Flayun/Projet_Arduino_Peip2/README.md

# Projet_Arduino_Peip2
Jeu d'échecs électronique
