Flayun/Projet_Arduino_Peip2/Rapport_Séance/Rapport de seance 7 Arthur Soens.pdf

## Rapport de la séance 7

Soens Arthur

J’ai , aujoud’hui , fiis les fotios utiles pou le dplaeet des pies ’est-à-dire celles liée à la

## pie ui , elle , peut aiteat se efee et s’ouvi , gâe à ei j’ai pu fialise la fotio ui

permet de prendre les pièces capturées pour les mettre hors du plateau de jeu. Pour ouvrir ou fermer la pince on utilise un servomoteur.

Initialisation du servomoteur :

//ServoMoteur

Servo servo;// rajouter les valeurs

byte pinServo;

void setup() {

//reglage servomoteur

servo.attach(pinServo);

Serial.println("Moteur initialisation");

}

Fonction pour ouvrir et fermer le moteur :

void fermerPince(){

servo.write(80);

}

void ouvrirPince(){

servo.write(30);

}

J’ai aussi amélioré le programme en remplaçant les « int » par des « byte » comme ci-dessous :

const byte stepPin = 3;

const byte dirPin = 4;

const byte stepPin2 = 6;

const byte dirPin2 = 7;

const byte stepPin3 = 13;

const byte dirPin3 = 14;

const byte stepPin4;//Rajouter les valeurs

const byte dirPin4;

## Et voii la fotio ui peet de pede la pie et l’expulse du jeu :

void piecePrise(int x, int y){

avancer_X_caseH(x);

avancer_X_caseV(y);

descendreLaPince(x, y);

fermerPince();

remonterLaPince(x, y);

avancer_X_caseH(10);

ouvrirPince();

}

## De plus , j’ai aid Ea à fialise la stutue e fixat ie les paeaux du as au aatue

talliue aisi u’e ajoutat ue aatue pou aohe u toisie oteur.
