Flayun/Projet_Arduino_Peip2/Rapport_Séance/Rapport de séance 8 Arthur Soens.pdf

### Rapport de la séance 8

Soens Arthur

J’ai , aujourd’hui , rajouté un support pour le moteur qui déplacera horizontalement la pince , ce support a pour but de stabiliser le dit moteur afin de le déplacer sans problème, néanmoins , le moteur n’agit pas exactement de la manière dont on espérait car il effectue une rotation au lieu d’un translation , mais nous pensons régler le problème en le bloquant par derrière limitant les possibilités de rotation. De plus , nous avons réglé un problème qui empêché la pince de fonctionner , ceci en remplaçant les pins dédiés à la pince. Nous avons aussi effectué et réussi un test de déplacement vertical et horizontal de la barre , il ne nous reste plus qu’à monter la pince et sa poulie sur le
système se déplaçant .
