Flayun/Projet_Arduino_Peip2/Rapport_Séance/Rapport de seance 6 Arthur Soens.pdf

Rapport de la séance 6

Soens Arthur

## J’ai aujoud’hui alio o pogae e ajoutat ue fotio peettat de vifie la taille des pies , pou e faie j’ai epla les pies hautes pa des à la plae de puis j’ai ue

fonction de vérification qui renvoie un booléen :

boolean verifierTaille(int x, int y){

if(jeu[x][y] == 1){

return true;//pièce de petite taille

}

else if(jeu[x][y] == 2){

return false;//pièce de grande taille

}

}

De plus j’ai fait les deux fonctions permettant de faire descendre et remonter la pince :

void descendreLaPince(int x, int y){//coordonné de la pince

if(verifierTaille(x, y)){

for(int i=0; i<200;i++){//éventuellement changer les valeurs pour descendre plus ou moins bas

digitalWrite(stepPin4,HIGH);

delay(20);

digitalWrite(stepPin4,LOW);

delay(20);

}

}

else{

for(int i=0; i<100;i++){//éventuellement changer les valeurs pour descendre plus ou moins bas

digitalWrite(stepPin4,HIGH);

delay(20);

digitalWrite(stepPin4,LOW);

delay(20);

}

}

}

void remonterLaPince(int x, int y){

digitalWrite(dirPin4,LOW);

if(verifierTaille(x, y)){

for(int i=0; i<200;i++){//éventuellement changer les valeurs pour descendre plus ou moins bas

digitalWrite(stepPin4,HIGH);

delay(20);

digitalWrite(stepPin4,LOW);

delay(20);

}

}

else{

for(int i=0; i<100;i++){//éventuellement changer les valeurs pour descendre plus ou moins bas

digitalWrite(stepPin4,HIGH);

delay(20);

digitalWrite(stepPin4,LOW);

delay(20);

}

}

digitalWrite(dirPin4,HIGH);

}

Ensuite , nous avons ,avec Emma ,finis le gros de la structure en fixant les crémaillères à une

## stutue de tal puis ous avos pu ostate u pole au iveau d’u oteu , l’oigie du

problème reste encore inconnue .

## Nous avos aussi fix la pie , il e ous este do , u’à faie le pogae pou ouvi et fermer

la pince.
