Flayun/Projet_Arduino_Peip2/Rapport_Séance/Rapport de seance 5 Arthur Soens.pdf

### Rapport de la séance 5

Soens Arthur

Partie pratique :

## Das la iuie sae je e suis oup d’eleve les attahes su plusieus pies de tal sevat à ote la stutue de ote jeu d’hes. Pou pouvoi te ot, ette stutue devait te opos de huit pie de tal ’est pouuoi j’ai utilisé la scie à métaux pour en ajouter 4 à

notre collection pré existante. De plus, on à demandé les deux moteurs manquant à notre projet puis nous essayons de finaliser le code avec les déplacements décrit en Bluetooth. Dans le code, nous avons détecté un problème, notre ordinateur ne détecte pas le message envoyé par le téléphone à qui il est connecté en Bluetooth.

Partie réflexion :

## Nous avos aujoud’hui oteu la pie ui fotioe à l’aide d’u sevooteu, ous hehos encore comme bien la monte puis ous l’attaheos à ue poulies afi de pouvoi dplae les

pièce au mieux.

Pour la séance prochaine :

Pour la prochaine séance je vais essayer de finaliser les déplacements des moteurs et peut être aussi celle de la pince.
