Flayun/Projet_Arduino_Peip2/Rapport_Séance/Rapport de seance 4 Arthur Soens.pdf

Rapport de la séance 4

Soens Arthur

Partie pratique :
Dans la quatrième sae je ’ai pas pu pogae suite a u problème de opilatio d’oigie

inconnue (la compilation ne se finissait pas) et une panne des deux moteurs ainsi que de leur puce,
j’ai do laiss à Ea le soi de fii les pogaes oeat le odule Bluetooth. Pendant ce
temps je me suis occupé de la partie matérielle, j’ai notamment limé les crans des crémaillère et roue

denté afin de réduire les efforts qui seront exercé par le moteur, en effet les coins des roues denté butait sur les bords des crans de la crémaillère.

Partie réflexion :
N’ayat pas eoe la pie , ous avos pu flhi su la foe fiale de la « machine », notamment pour la pince nous allons probableet la faie tei au out d’u fil ui s’eoulea ou se doulea autou d’u oteu Nea 17.De plus o s’est pos la uestio de la taille des pies,

nous aurions pu les séparer en deux catégorie , les pièce de grande taille et celle de petite taille ,
ais ous pesos à leu attahe u fil u de fe autous d’elle puis de faie u aeau ui otiu au-dessus de la pie oe pou phe la pie , aisi la pie e seai opos ue d’u
sevooteu et d’u haeço e foe de « L » qui prendrais les pièces pour les déplacer.

Pour la séance prochaine :

Pour la prochaine séance, je vais commencer le programme de la pince afin de pouvoir finaliser la
patie physiue du pojet et si j’ai eoe du teps, essaye de pogae les ouveets valide

ou non.
