Flayun/Projet_Arduino_Peip2/Rapport_Séance/Rapport_Seance_3_Glesser_Emma.pdf

Glesser Emma G3

Rapport séance du 10 janvier 2020

Répartition globale :

Arthur s’est occupé de plusieurs fonctions concernant le déplacement des pièces

J’ai travaillé sur le module wifi ESP8266 pour établir une connexion RF.

Travail durant la séance

N’ayant pas beaucoup d’informations sur le module, je suis allée me renseigner.

Le module peut donc être utiliser de différentes manières. En tant que station à l’écoute des réseaux wifi environnants, en tant qu’émetteur d’un propre réseau wifi ou bien les deux.

C’est le deuxième qui nous intéresse car on pourra se connecter avec l’ordi et donc
envoyer les commandes via ce réseau.

J’ai dans un premier temps, échanger les

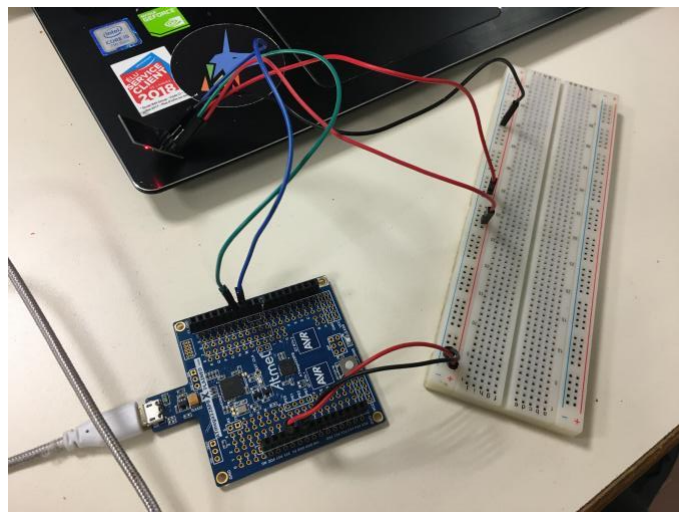
[picture p17: figure]

commandes via le moniteur série, comme on l’avait fait avec le module Bluetooth. Puis en passant par une fonction qui prend en argument la commande que l’on passait initialement sur le moniteur série. Puis j’ai essayé de le configurer de façon à pouvoir obtenir un réseau wifi sur lequel on connectera l’ordinateur. Malheureusement cela m’a pris beaucoup de temps pour faire des recherches, sans aboutir à un résultat concluant pendant la séance. Je vais donc poursuivre cette étape chez moi.

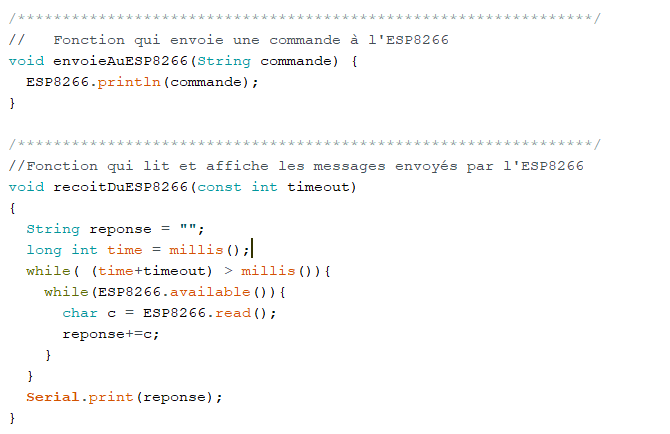
[picture p18: figure]

Différents programmes

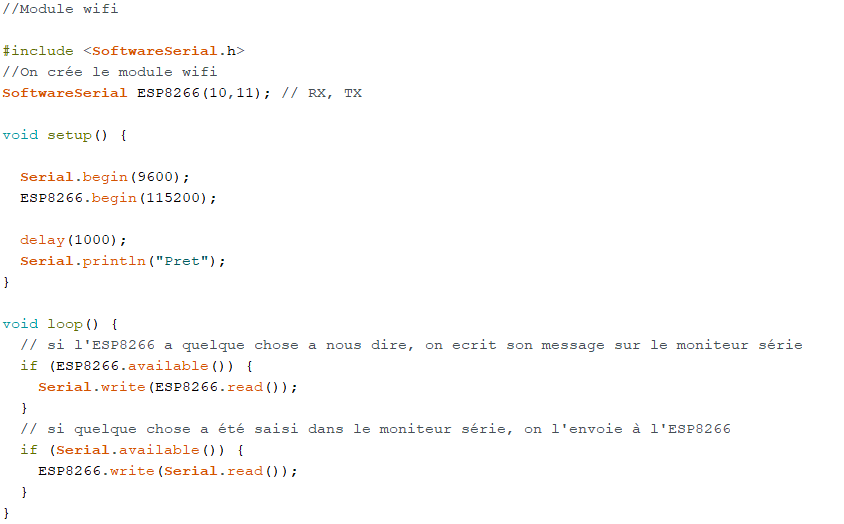
[picture p19: figure]
